leistimo/BreadboardPowerSupplyBook/BreadboardPowerSupplyTimLeishman.pdf

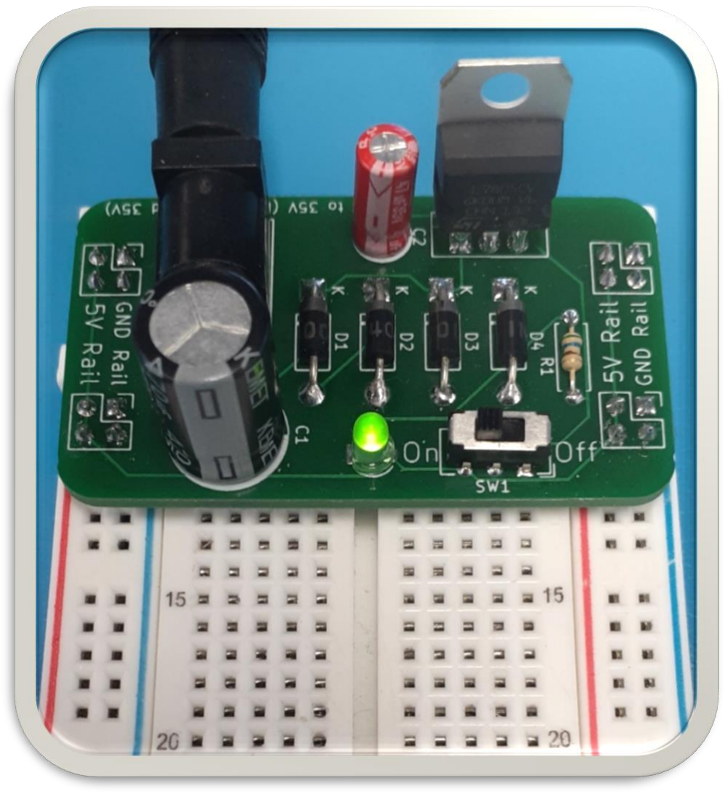
[picture p1: figure]

# Breadboard Power Supply

## Timothy Leishman

### Senior Instructor, Robotics Engineering Technology Idaho State University

## Contents

- Section 1 | Introduction | 2
- Section 2 | RMS & Peak Voltage | 4
- Section 3 | Voltage Rectification | 5
- Section 4 | Capacitive Filtering & DC Calculations | 7
- Section 5 | Voltage Regulation | 9
- Section 6 | Your First Power Supply Project | 13
- Section 7 | Zener Regulation | 16
- Section 8 | Input Polarity Correction | 20
- Section 9 | Basic Current Limiting Protection | 21
- Section 10 The Darlington Pair | 24
- Section 11 The L7805 Regulator | 26
- Section 12 Breadboard Power Supply Assembly | 29
- Conclusion | 32
- References | 33

Section 1 Introduction

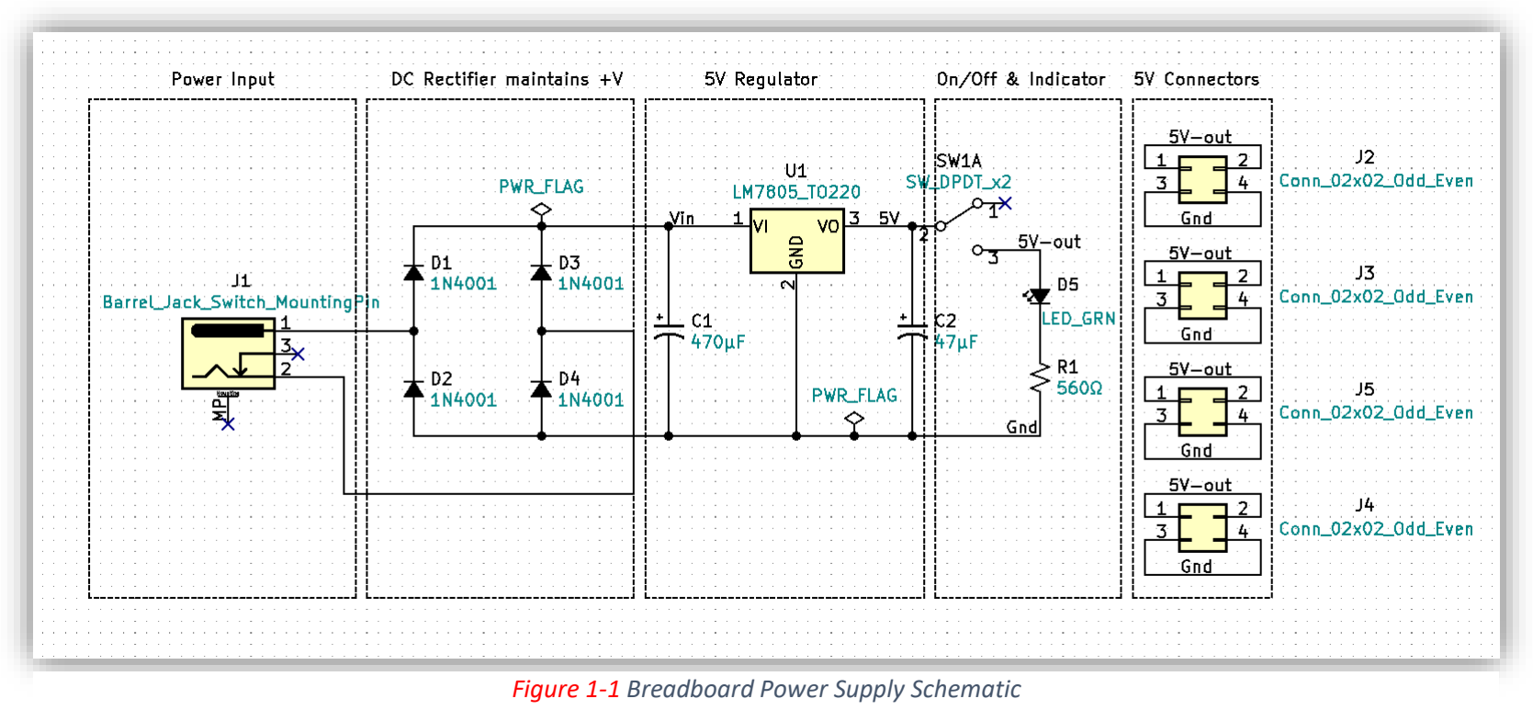
[picture p2: figure]

In addition to a global pandemic, Covid created an instant demand for online at home

learning. Suddenly electronics students everywhere lost access to laboratory bench test

equipment and the direct supervision of a lab instructor. While, I encourage advanced students to

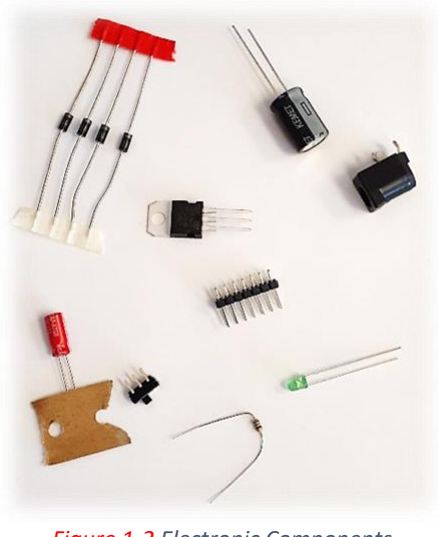
[picture p3: figure]

acquire modestly priced oscilloscopes, function generators,

and laboratory DC power supplies as they can, the

introductory student will not likely have access to these tools

at home. For these students, the Breadboard PS along with a

DMM will provide an affordable and safe, at-home circuit

prototyping solution.

The electronic circuit design process involves

defining a problem, determining a solution, completing

circuit calculations & developing a schematic, acquiring

components, testing the circuit (often referred to as breadboarding), designing a printed circuit

Figure 1-2 Electronic Components

Figure 1-1 Breadboard Power Supply Schematic board (PCB), assembling the PCB, and final PCB testing. Typically, the breadboarding stage is

done using a bench top or laboratory DC power supply. Once the breadboarding phase is

complete and the circuit is functionally operational, we often need to replace the laboratory DC

power supply with a dedicated power source. A power source can be as simple as a 9V battery or

as sophisticated as a dedicated high-power rackmount subsystem. Often, we can design our own

power supplies using basic components rather than buying the off-the-shelf unit.

While the power supply may not be the

most exciting aspect of your electronic projects it

is a crucial and foundational component. Poor

power supply design can lead to intermittent

circuit problems, premature circuit failures, and

frustration! Understanding how power supplies

operate and function will make you a better

electronic troubleshooter. The Breadboard Power

Supply will give you the ability to safely build

and test circuits. This small project will also help

you develop your soldering skills. Additionally,

learning how to safely design and build dedicated

power supplies will bring life to your current and

future electronic projects.

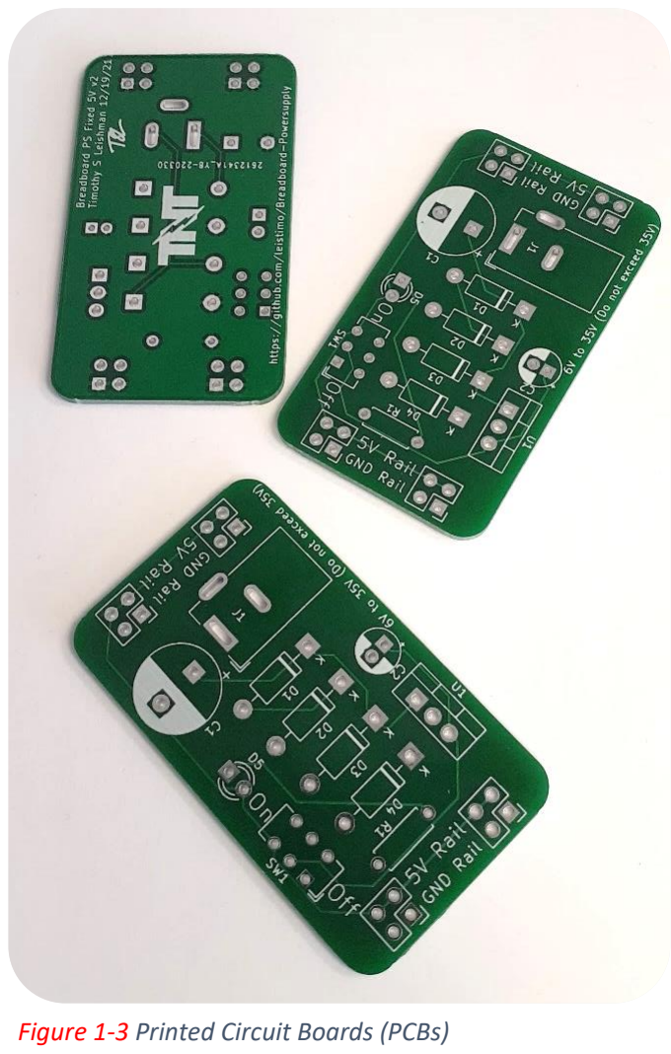
[picture p4: figure]

Figure 1-3 Printed Circuit Boards (PCBs)

Section 2 RMS & Peak Voltage

The wall outlet at your house is 120-volt rms. 120vrms is dangerous. The circuit breaker

at your house, which acts like a safety switch turning off the voltage, has the maximum current

rating of 15 amps or 20 amps. Death can occur from as low as 100mA or 0.1A. The circuit

breaker at your house is not designed to save your life from electrical shock, it is designed to

prevent the wiring in your home from overheating and starting a fire. Do not underestimate 120v

wall power it can kill you! For more safety information, see OSHA’s Basic Electrical Safety. (https://www.osha.gov/sites/default/files/2019-04/Basic_Electricity_Materials.pdf)

Wall voltage is known as AC (Alternating Current). Most of what we do in electronics is

DC (Direct Current). Examples of DC devices include: your computer, cell phone, Arduino,

Raspberry Pi, and anything powered by a battery. The motor in your RC car is DC motor.

However, some motors are designed to operate using single phase AC or industrial three phase

AC. Because our wall power is AC and our electronic circuits are predominately DC we will

need to convert the alternating wall

current to direct current, a process

called rectification.

Figure 2-1 shows a captured

image of 120vRMS wall AC. An

oscilloscope displays voltage along

the Y axis and time along the X

axis. Observe that the oscilloscope

displays the image in alternating

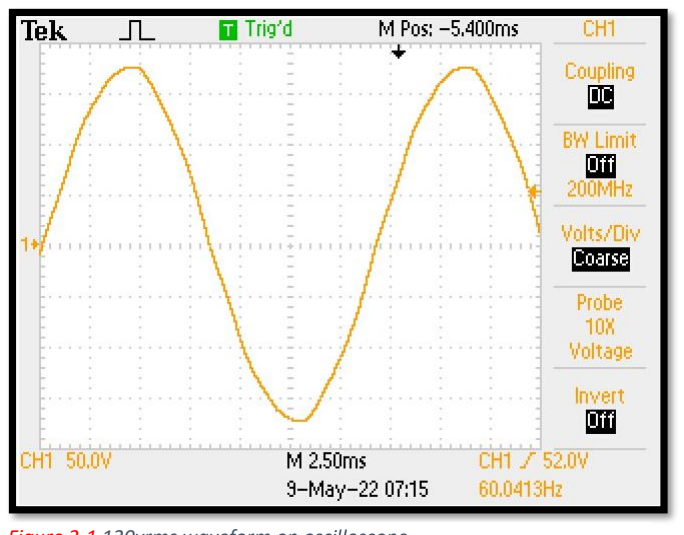
[picture p5: figure]

peak-to-peak voltage, not RMS voltage.

Figure 2-1 120vrms waveform on oscilloscope

To convert peak-to-peak voltage to RMS voltage, the following formulas can be used.

Vrms =

Vp
√2

OR Vp × 0.707. Vp is peak voltage and is equal to Vpp (peak to peak voltage)

divided by two or Vp =

Vpp
2

. In figure 2-1 note that channel 1 is set to 50 volts per division and

the waveform, peak to peak, has approximately six major divisions and two half divisions

equaling 7 major divisions. If we multiply 7div × 50v/div to get a peak to peak voltage of

350vpp. Dividing 350vpp by 2 gives us a peak voltage of 175vp. Dividing 175vp by √2

gives an RMS voltage of 123.74vRMS or 120vRMS. Peak voltage is important to understand

when we are using an oscilloscope and calculating rectification circuits. RMS is useful for

determining power. For example, the power calculations for an incandescent light bulb, audio

amplifier, and ac motor need to be calculated by multiplying the RMS voltage by the RMS

current. Using RMS voltage to calculate ac power gives us an equivalent power to DC power

calculations, meaning 1v rms × 1amp rms = 1 watt & 1VDC × 1amp DC = 1 watt. 1 watt

is the energy needed for both scenarios.

Section 3 Voltage Rectification

Voltage rectification is the process of changing AC (alternating current) to DC (direct

current). Knowing that 100mA of current can be lethal and that in-general, skin resistance of a

human is between 10KΩ & 1KΩ (1KΩ when wet), we can use Ohm’s Law, where Current =

Voltage
Resistance

, to determine a relatively safe voltage. If we convert 120vrms to peak we get vp =

120V × √2 or vp = 169.71vp. Assuming we were able to rectify the 169.71volts we can use

the human resistance of 1KΩ to determine the current potential, i amps =

169.71V
1000Ω

, i =

169.71mA. This current is potentially lethal. If 100mA is our threshold for lethal current. What

is the maximum “safe” voltage?

Calculate the max voltage by Vmax = 1KΩ × 100mA, Vmax = 100v. Where we know

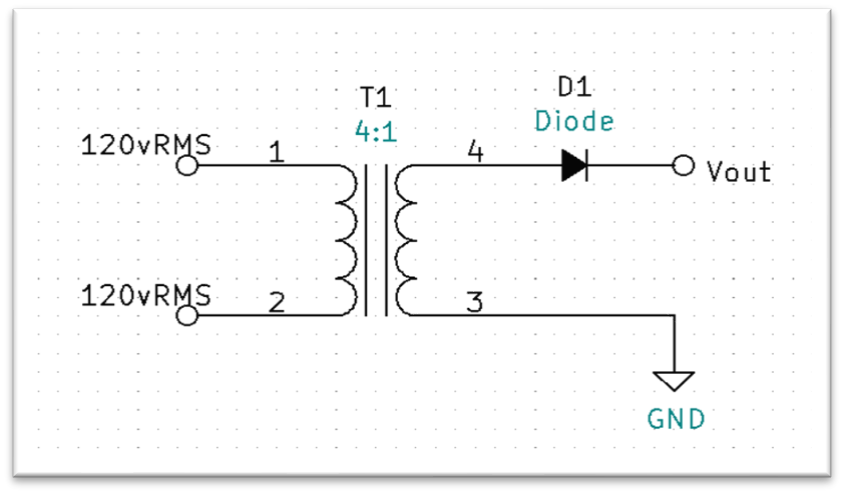
[picture p6: figure]

that 100Vs and above is potentially

lethal for humans, less than 100V

should be less than lethal. Figure 3-1

shows a basic unregulated half-wave

voltage rectifier circuit where,

transformer T1 is used for isolation

and safety. Notice that T1 has a 4:1

turns ratio. T1 is a step-down

transformer, meaning that the primary side (pins 1 & 2) have four times more turns than the

secondary side (pins 3 & 4). A step-down transformer’s secondary voltage will be divided by the

turns’ ratio. For a 4:1 transformer, vSecondary =

Vprimary
4

=

169.71vp
4

= 42.43vp. Figure 3-2

shows the secondary voltage waveform of T1

pin 3 to pin 4.

The voltage has been stepped down to

around 42vp. The waveform however, is still

AC. Observe the frequency for both fig 2-1 and

fig 3-2. Frequency is measured in hertz (Hz)

and both the primary and the secondary are

measuring the same frequency at 60Hz which

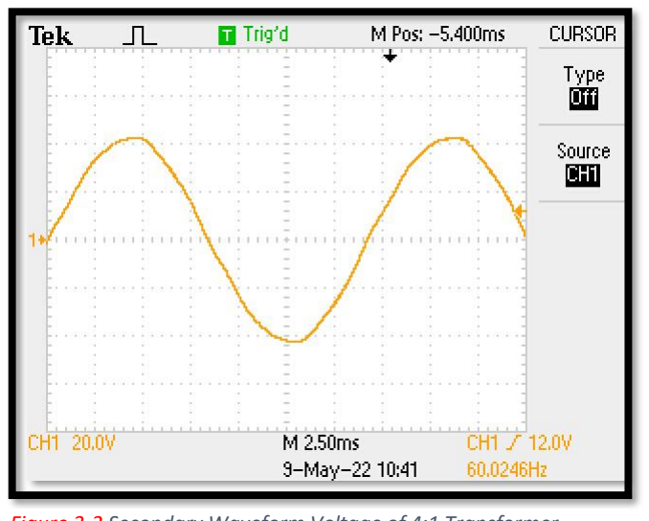
[picture p7: figure]

is the standard frequency for AC power in the United States.

Figure 3-1 Basic Half Wave Rectifier Circuit

Figure 3-2 Secondary Waveform Voltage of 4:1 Transformer

The diode D1 of Figure 3-1 will provide rectification by acting like a switch and allowing

current to flow in only one direction. When the anode is

positive with respect to the cathode, current will flow.

When the anode is negative with respect to the cathode

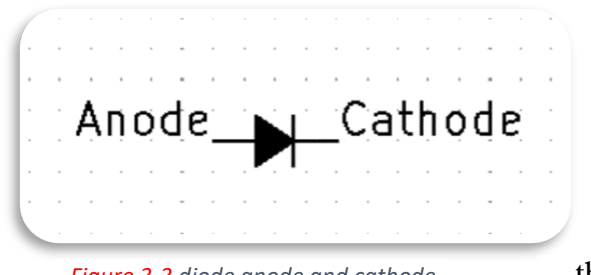
[picture p8: figure]
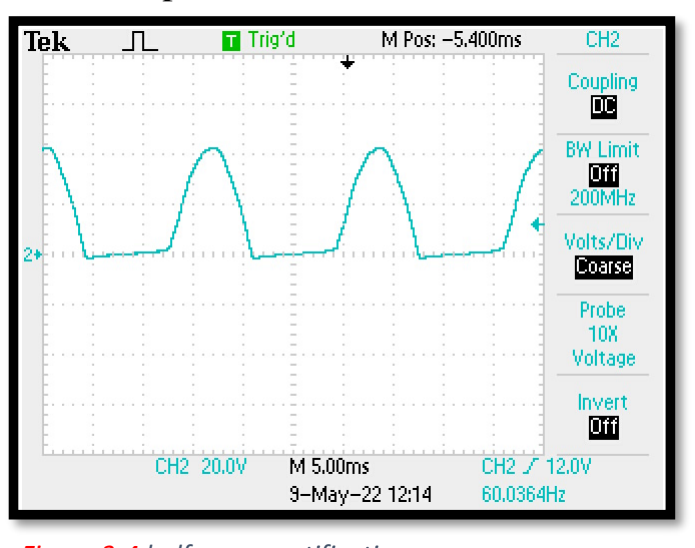
[picture p9: figure]

the diode will act like an open and no current will flow.

The output waveform will now appear to have the

negative peaks clipped off (See fig 3-4). The current

is flowing in one direction and basic half-wave

rectification has been achieved. Notice the

waveform frequency is still 60Hz for half-wave

rectification.

Section 4 Capacitive Filtering & DC Calculations

Figure 3-3 diode anode and cathode

Figure 3-4 half-wave rectification

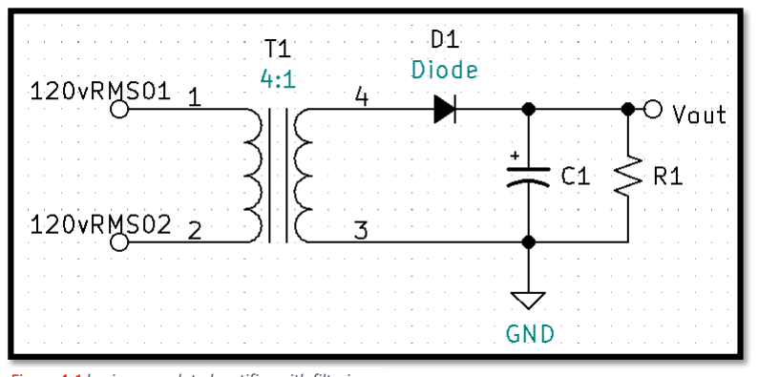
[picture p10: figure]

Figure 4-1 basic unregulated rectifier with filtering

By adding a filtering capacitor, we can smooth the ripple waveform to make it a better

DC. Figure 4-1 has added a filter capacitor C1 in parallel with load resistor R1. The capacitor

will charge immediately when the diode D1 is forward biased. When the diode becomes reverse

biased the capacitor will discharge through the load R1. With a large enough capacitance value

and load resistor the output will be a smooth DC. We can test this by using a 10uF capacitor with

no load, a 10KΩ load, and a 1KΩ load to show the varying degrees of ripple (see figures 4-2,4-3,

& 4-4).

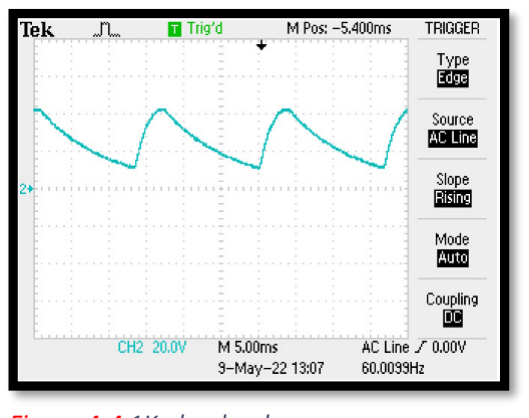
[picture p11: figure]
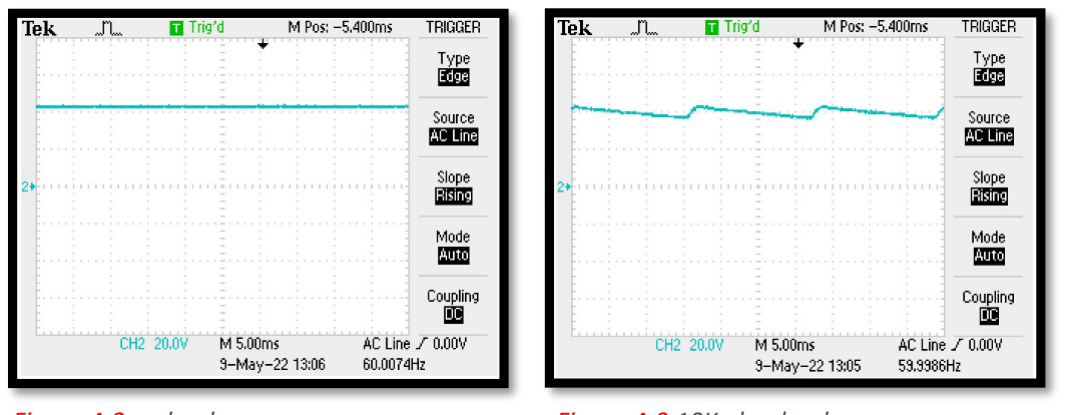
[picture p12: figure]

When there is ripple present on the waveform, VDC can be thought of as the average

waveform voltage. VDC can be calculated by adding the maximum positive peak voltage to the

minimum peak voltage and then dividing the sum by two.

Example Calculate VDC for figure 4-4:

VDC =

Vmax+Vmin
2

Vmax = 2.1 div × 20v⁄div = 42v

Vmin = 0.5 div × 20v⁄div = 10v. Now find VDC.

VDC1KΩ =

Vmax+Vmin
2

=

42v+10v
2

= 26V.

Figure 4-2 no load | Figure 4-3 10K ohm load | Figure 4-4 1K ohm load

Section 5 Voltage Regulation

For Figures 4-2, 4-3, & 4-4 observe that as the load is increased, (Ohm’s law I =

V
R

,

current or “load” increases as resistance is decreased), the ripple voltage increases and as the

ripple increases the effective DC voltage decreases.

This is an example of a rectifier circuit that is

unregulated. An unregulated power supply’s DC

voltage will decrease as the circuit load current is

increased.

For many circuits having an unregulated power

supply is a problem. Voltage regulation is required for

any circuit that requires smooth consistent DC voltage

across varying loads or current demands. Figure 5-1

shows a common collector amplifier which can be used

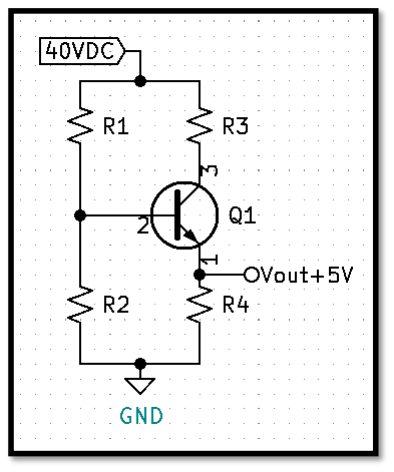
[picture p13: figure]

to provide basic voltage regulation. To calculate the needed resistors R1 thru R4, an output

voltage must be determined. Next, determine the maximum current need for your circuit. For this

example, we will use 5V with a maximum current need of 5mA. Calculate the base current (pin

2) of the transistor by dividing the 5mA emitter current (pin 1) by the minimum beta (also known

as hfe) per the data sheet. The minimum hfe for the 2N3904 with a collector current near 5mA

will be will be between 80 and 100, see figure 5-2.

- IB ≈

5mA
90

≈ 55.556μA

Figure 5-2 data sheet excerpt for a 2n3904 transistor

Figure 5-1 Basic Voltage Regulation Circuit

With IB known, make IR2 a minimum of 10 times larger.

- IR2 ≥ (10 × IB) ≥ (10 × 55.556μA) ≥ 555.556μA

Use Kirchhoff’s Voltage Law to calculate VR2.

- VR2 = VR4 + VBE = 5V + 0.7V = 5.7V

Use Ohm’s Law to calculate R2

- R2 =

VR2

IR2

=

5.7V
min555.556μA

= 10.26KΩ

- Round down to next standard value, R2 = 10KΩ

Recalculate IR2 using standard value.

- IR2 =

VR2
R2

=

5.7V
10KΩ

= 570μA

Calculate IR1 using Kirchhoff’s Current Law.

- IR1 = IB + IR2 = 55.556μA + 570μA = 625.556μA

Calculate VR1 using Kirchhoff’s Current Law.

- VR1 = VCC − VR2 = 40V − 5.7V = 34.3V

Calculate R1 using Ohm’s Law.

- R1 =

VR1

IR1

=

34.3V
625.556μA

= 54.831KΩ

R3 is used to help split the power from the transistor. Power for the transistor is calculated using

the max current IC multiplied by VCE.

- PQ1 = ICmax × VCE
- ICmax ≈ 5mA
- VCEmax = VCC − VR4 = 40V − 5V = 35V
- Now make VCE =

VCEmax
2

=

35
2

= 17.5V

- PQ1 = ICmax × VCE = 5mA × 17.5V = 87.5mW

Calculate VR3 using Kirchhoff’s Voltage Law.

- VR3 = VCC − VCE − VR4 = 40V − 17.5V − 5V = 17.5V

Calculate IR3.

- IR3 ≈ 5mA

Calculate R3 using Ohm’s Law.

- R3 =

VR3

IR3

=

17.5V
5mA

= 3.5KΩ

Figure 5-3 displays the regulation circuit with

standard values. Figure 5-4 shows the entire

rectification circuit with voltage regulation

added. Notice the second 10uF capacitor C2 at

the base of the transistor. This is used to keep the

voltage and current at the base of the transistor

extra stable. Figure 5-4 transistor orientation is

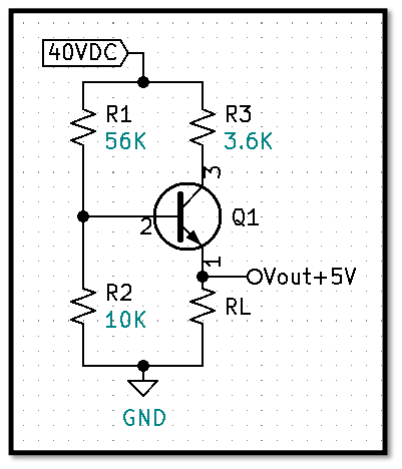
[picture p14: figure]

also drawn in the more typical manner for a power supply.

Figure 5-3 Basic Regulation Circuit with Standard Values.

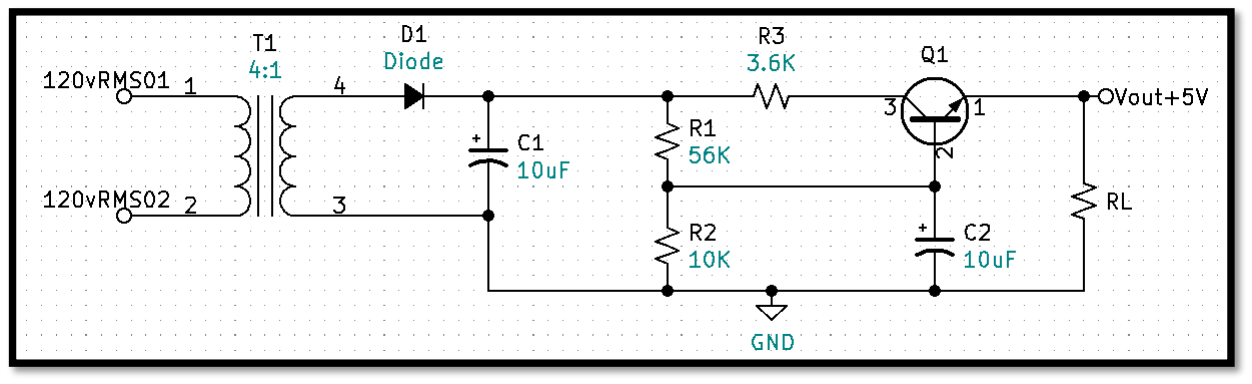
[picture p15: figure]

Figure 5-4 Basic Rectification Circuit with Voltage Regulation

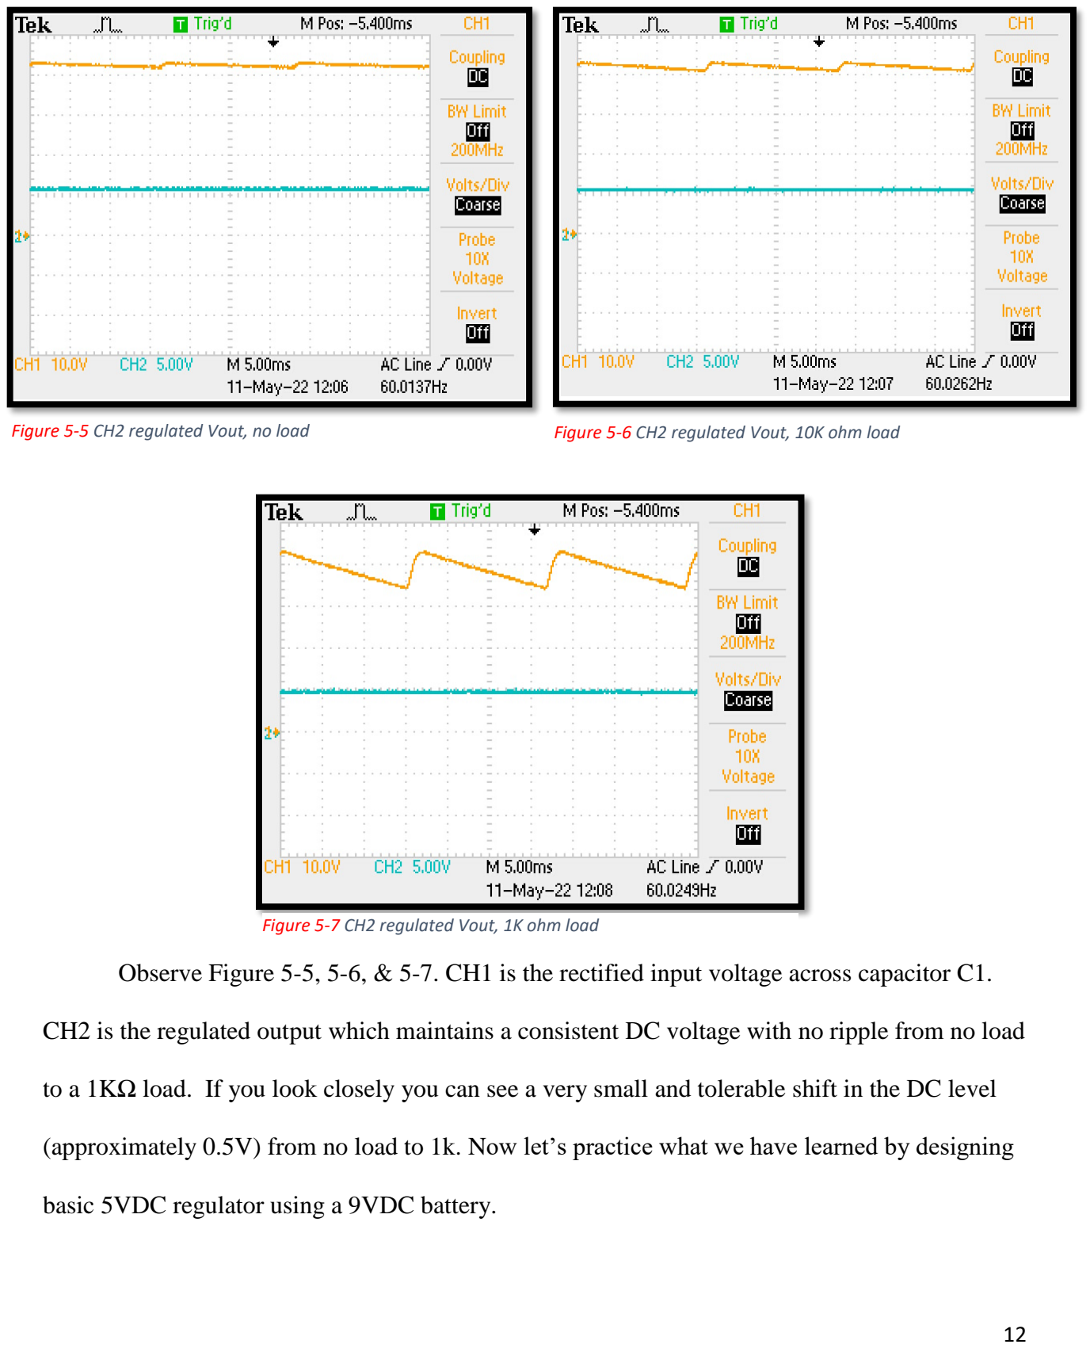
[picture p16: page 13]

Observe Figure 5-5, 5-6, & 5-7. CH1 is the rectified input voltage across capacitor C1.

CH2 is the regulated output which maintains a consistent DC voltage with no ripple from no load

to a 1KΩ load. If you look closely you can see a very small and tolerable shift in the DC level

(approximately 0.5V) from no load to 1k. Now let’s practice what we have learned by designing

basic 5VDC regulator using a 9VDC battery.

Figure 5-5 CH2 regulated Vout, no load | Figure 5-6 CH2 regulated Vout, 10K ohm load

Figure 5-7 CH2 regulated Vout, 1K ohm load

Section 6 Your First Power Supply Project

We learned previously that the human skin resistance is around 1KΩ when wet and

10KΩ when dry. We also learned that 100mAs of current is potentially lethal. If we use a 9VDC

battery as our voltage source, what is the maximum current through wet skin and minimum

current through dry skin potential exposure? (use Ohm’s Law)

- Wet skin: Iwet =

V
R

=

9V
1KΩ

= 9mA

- Dry skin: Idry =

V
R

=

9V
10KΩ

= 900μA

With dry skin you will not be able to feel or perceive the less than 1mA of current from a

9V battery. If wet however, you could potentially feel a non-lethal shock. Regardless of the

voltage level you are working with, remove all metal jewelry. Metal jewelry can cause severe

burns even when working with low voltage.

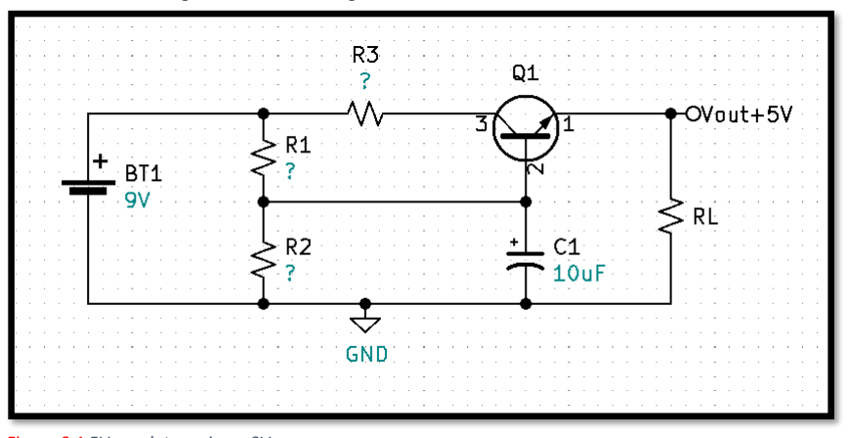
[picture p17: figure]

First Challenge: Calculate and find the resistor values for the circuit in Figure 6-1 to produce a

regulated 5V output with a max current of 5mA. Assume Q1 is a 2N3904 with a minimum beta

of 90.

Figure 6-1 5V regulator using a 9V source

Solution for First Challenge:

Find the maximum base current IB for Q1.

- IBmax ≈

IEmax
Betamin

≈

5mA
90

≈ 55.556μA

Make IR2 ≥ 10 x IBmax.

- IR2 ≥ 10 × 55.556μA ≥ 555.556μA

Find VR2 using Kirchhoff’s Voltage Law.

- VR2 = VBE + VRL = 0.7V + 5V = 5.7V

Find approximate R2 value using Ohm’s Law.

- R2 ≤

VR2

IR2

≤

5.7V
555.556μA

≤ 10.26KΩ

Round R2 value down to a standard value.

- R2 = 10KΩ

Recalculate IR2 using Ohm’s Law.

- IR2 =

VR2
R2

=

5.7V
10KΩ

= 570μA

Find IR1 using Kirchhoff’s Current Law.

- IR1 = IR2 + IB = 570μA + 55.556μA = 625.556μA

Find VR1 using Kirchhoff’s Voltage Law.

- VR1 = VBT1 − VR2 = 9V − 5.7V = 3.3V

Calculate R1 using Ohm’s Law.

- R1 =

VR1

IR1

=

3.3V
625.556μA

= 5.28KΩ

Determine R3. First ask yourself what the total power of Q1 is without R3 and if that

power needs to be split.

- PQ1 = ICmax × VCE
- VCEmax = VBT1 − VRL = 9V − 5V = 4V
- ICmax = 5mA
- PQ1 = ICmax × VCE = 5mA × 4V = 20mW

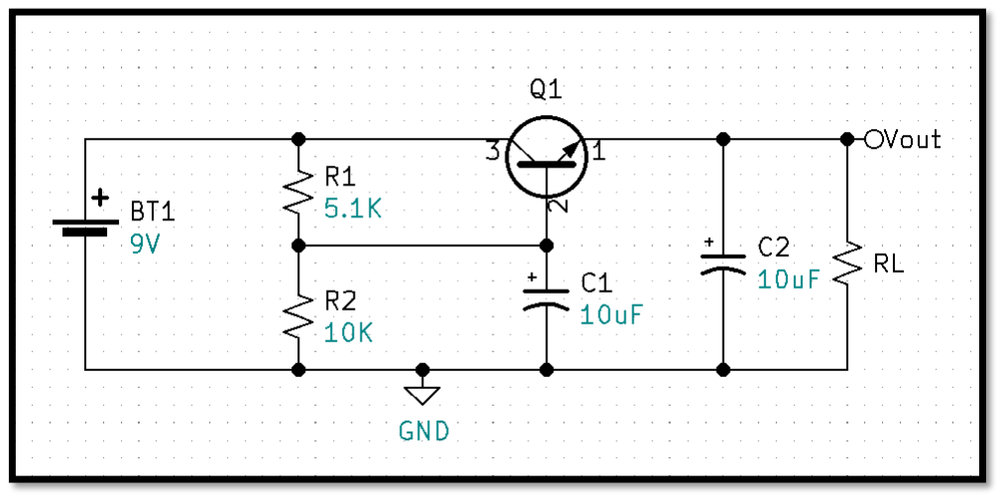
[picture p18: figure]

The absolute maximum power rating for a 2N3904 is 625mW. Optimal power operation

for the 2N3904 will be less than or equal to half the absolute maximum rating, approximately

300mW. Because we are well below the optimal power operation at 20mW, R3 is not required

for this circuit.

With figure 6-2 assembled and tested, the output measured a smooth 5.04V with a 1KΩ

load resistor and 5.44V with no load. This circuit works well for a specific input voltage, in this

case 9VDC. Let’s say we want to design a circuit that has the ability to accept a variety of input

voltages instead of just 9V. How might we deal with a range of input voltages and still maintain

a regulated output of 5V?

Figure 6-2 Test Circuit - R1 Standard Value, Additional Filter Cap C2.

Section 7 Zener Regulation

If you are like me, you have a box full of salvaged

electronic components. I have one dedicated to wall

ACDC power adapters as seen in Fig. 7-1. These wall

adapters, sometimes referred to as “wall warts” take care

of voltage rectification for us by internally converting the

120Vrms AC voltage to a fixed DC voltage. Typically,

the output voltage and current specifications are written

on the adapter. The adapter in Fig 7-1 is listed as having

an output of 10.5V that can supply up to 900mAs of

current. Let’s say I also have a wall adapter that has a

12V output and third that has a 20V output. Can we

design a single circuit that will accommodate each of

those inputs and still provide a regulated 5V output? By

replacing R2 in our previous circuit with a Zener diode

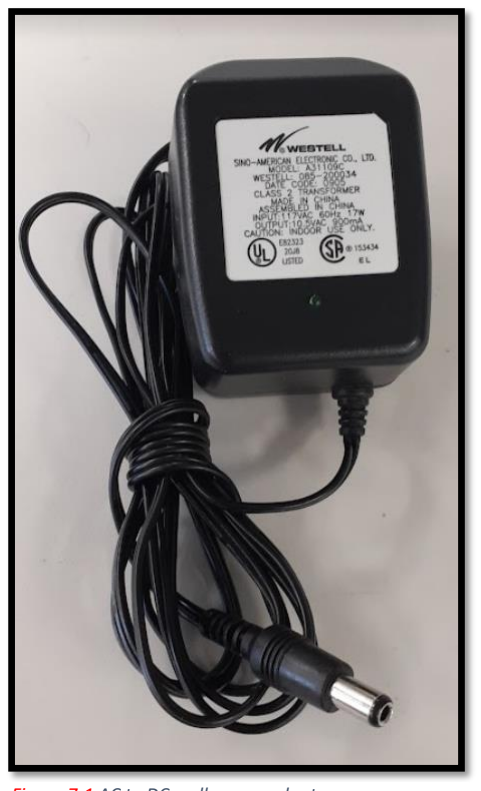
[picture p19: figure]

we can achieve regulation throughout a range of input voltages.

Figure 7-1 AC to DC wall power adapter with barrel jack connector

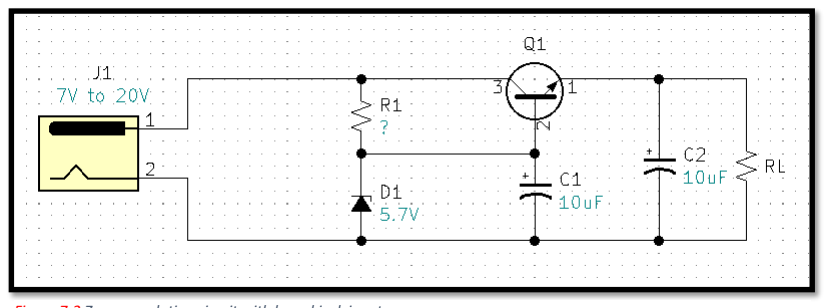
[picture p20: figure]

Figure 7-2 Zener regulation circuit with barrel jack input

R1 Calculations for Fig 7-2:

Ideally D1 would be a 5.7V Zener,

I had on hand a 1N5233 6V Zener diode.

Concerning Zener diodes, there are two

important specifications we need to know,

the maximum Zener current (IZM) and the

minimum Zener current known as knee

current (IZK). According to the data sheet

the maximum power for my Zener is

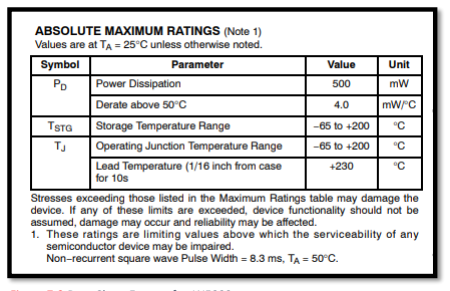
[picture p21: figure]

500mW. With this information we can calculate IZM.

Calculate IZM using the power formula.

- P = I × V
- I =

P
V
- IZM =

PZMax
VZ

=

500mW
6V

= 83.333mA

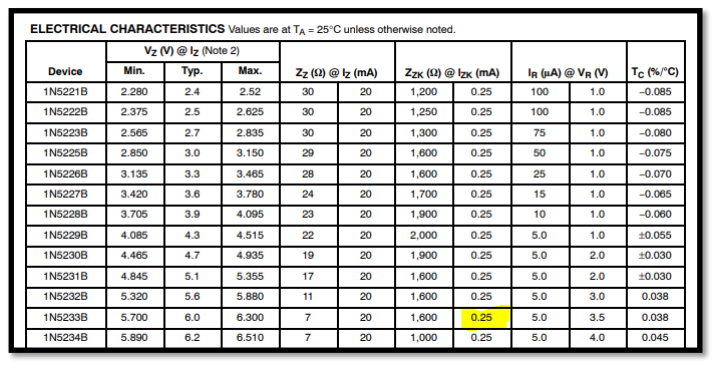
[picture p22: figure]

See Fig 7-4, according to the data sheet IZK = 0.25mA for the 1N5233 Zener diode.

Figure 7-3 Data Sheet Excerpt for 1N5233

Figure 7-4 Data Sheet IZK

You can determine your minimum input voltage by adding a minimum of two volts to

your regulated output voltage. This extra voltage is needed for the linear regulator to have at

least two volts VCE across the transistor. The transistor will lose regulation if its VCE drops too

low. For our example with a 5V output we would need a minimum of 7VDC for an input. Now

imagine that the input is 7V and the 6V Zener is doing its job. Using Kirchhoff’s Voltage Law,

we can see that VR1 will equal 1V. Here is the math.

With the input Voltage set to 7V:

- VR1 = Vin − VZ = 7V − 6V = 1V

We know that the Zener requires a minimum current of IZK therefore:

- R1 =

VR1

IZK

=

1V
0.25mA

= 4KΩ, round down to next standard value of 3.9KΩ

With the maximum input voltage of 20V chosen, verify IZ does not exceed IZM = 83.333mA.

With the input Voltage set to 20V:

- VR1 = Vin − VZ = 20V − 6V = 14V
- IZ =

VR1
R1

=

14V
3.9KΩ

= 3.59mA

- IZ is less that IZM, and within specifications.

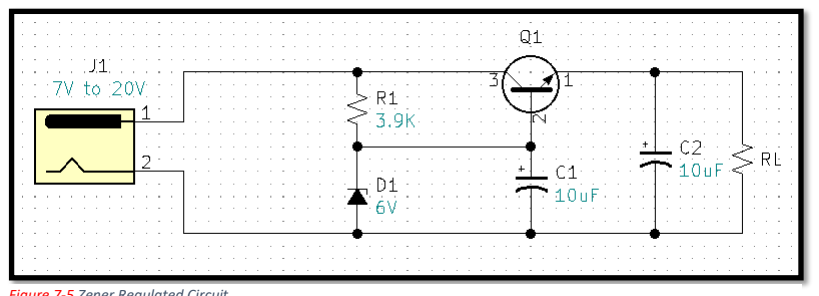
[picture p23: figure]

Figure 7-5 Zener Regulated Circuit

One more calculation that should be verified is the power of Q1when the input is at max 20V.

- PQ1 = IRLmax × VCE
- IRLmax = 5mA
- VCEmax = VINmax − VRL = 20V − 5V = 15V
- PQ1 = IRLmax × VCE = 5mA × 15V = 75mW
- PQ1 = 75mW is less tℎe maximum power for a 2N3904, PMax2N3904 = 625mW

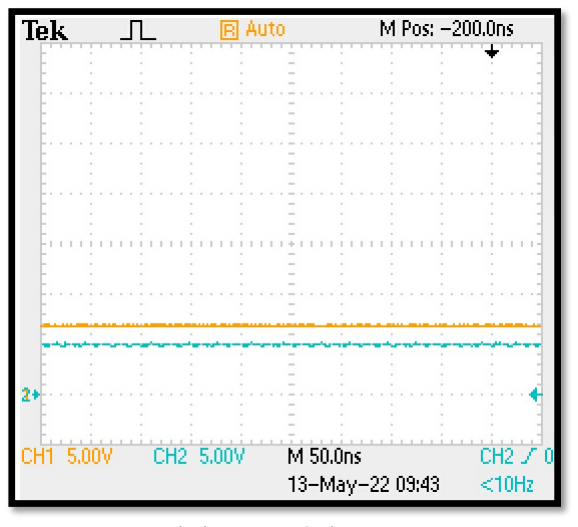
[picture p24: figure]

With Zener regulation we

can now regulate a range of

input voltages. Beware only

some barrel jack connectors that

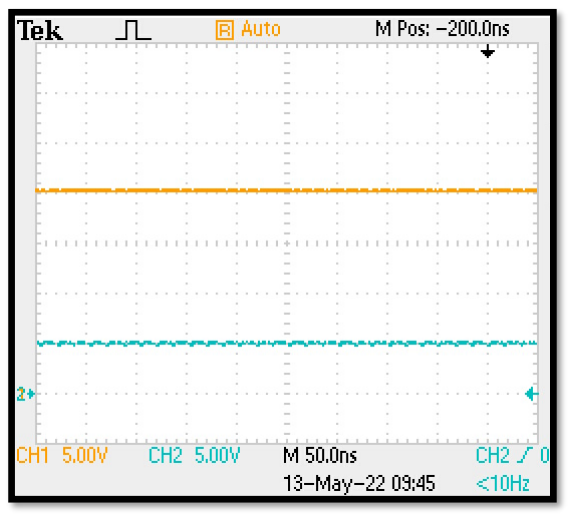
[picture p25: figure]
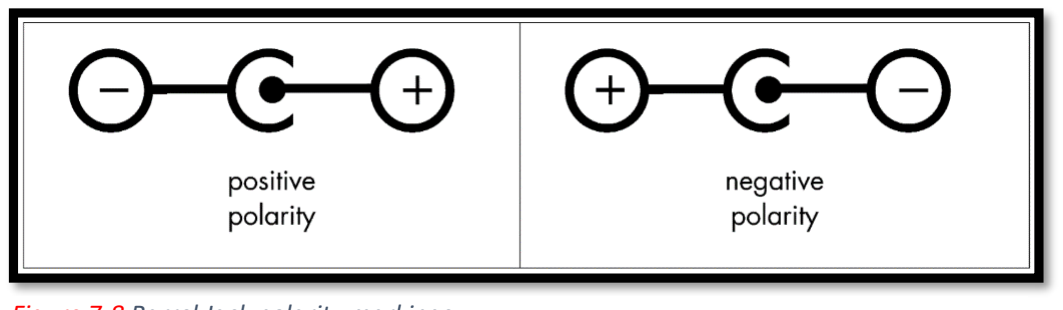
[picture p26: figure]

have a positive center pin. Have you ever noticed the symbol markings on your AC wall adapters

similar to Fig 7-8? In my box of salvaged adapters, I have some unmarked, some center positive,

and some center negative. Currently, we could damage our circuit, or the wall adapter, if we used

Figure 7-6 Measured, Ch1 7V input & Ch2 5V output. | Figure 7-7 Measured, Ch1 20V input & Ch2 5V output.

Figure 7-8 Barrel Jack polarity markings unmarked or center negative adapters. How could our circuit be fixed so that it could accept both

positive and negative center pin polarities and still output a fixed +5V?

Section 8 Input Polarity Correction

Similar to how we used diodes in our AC to DC voltage rectification circuit, we can use

diodes to provide DC polarity correction. For this example, I am using 1N4001 general purpose

diodes for D1-D4.

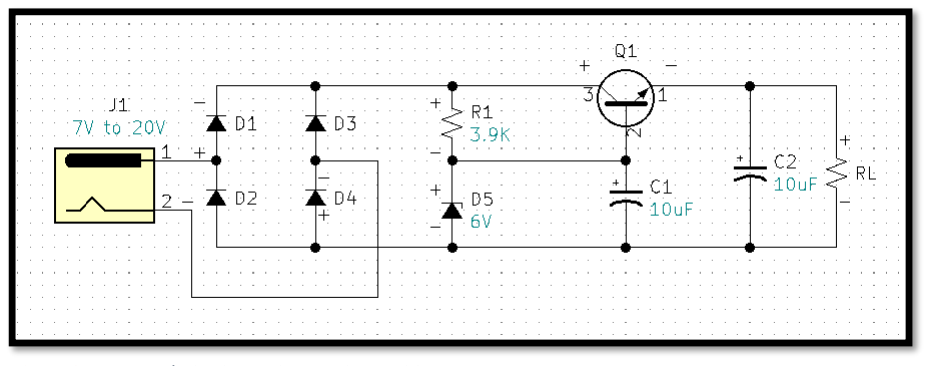
[picture p27: figure]
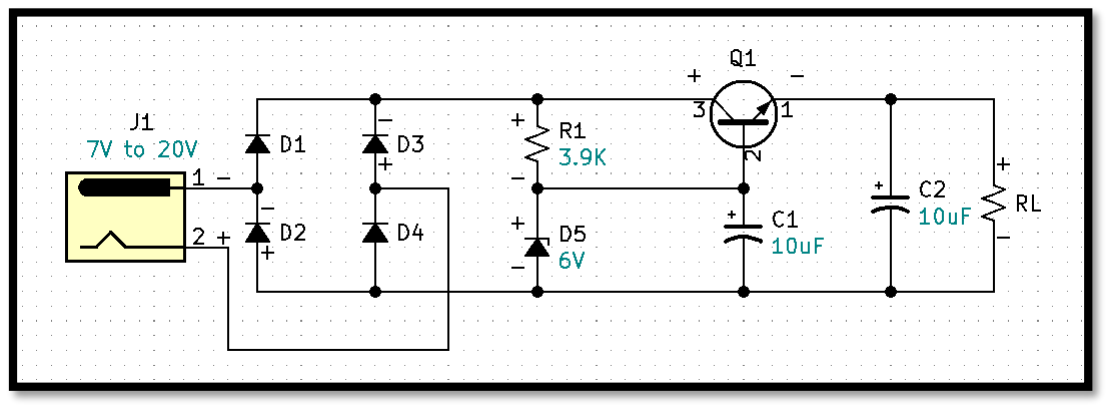
[picture p28: figure]

Observe Figure 8-1 where J1 pin 1 is positive with respect to pin 2, diodes D1 and D4 are

forward biased and diodes D2 and D3 are reverse biased. The result is the rest of the circuit is

properly biased. Observe Figure 8-2 where J1 pin 1 is negative with respect to pin 2, diodes D2

and D3 are forward biased and diodes D1 and D4 are reverse biased. The result is the rest of the

Figure 8-1 Input Polarity Correction, J1 Pin1 Positive.

Figure 8-2 Input Polarity Correction, J1 Pin1 Negative.

circuit is again properly biased. Therefore, the circuit is now adapted to receive either positive,

negative, or unknown voltage polarities. This circuit makes virtually all of our salvaged wall

adapters useable. I assembled and tested the circuit with +20VDC input measured +5.08VDC at

the output with a 1KΩ load. I also tested with -20VDC input and also measured +5.08VDC at

the output with a 1KΩ load.

What happens to this circuit if the output is shorted? The answer is the transistor will

exceed its power specifications and destroy itself. None of the previous circuits have had current

limiting protection. If you are building a dedicated circuit that will be deployed with a fixed load

and a fixed input voltage, and you can guarantee that the output will never be shorted, the

previous circuits may work fine. However, current limiting circuit protection is always a good

idea. What is a simple way to apply current limiting protection to our circuit?

Section 9 Basic Current Limiting Protection

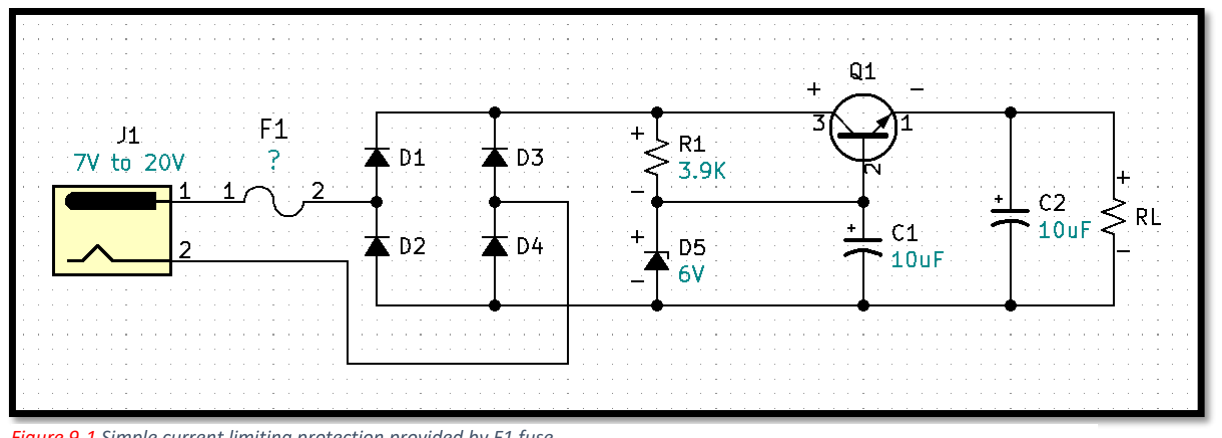
[picture p29: figure]

A fuse can provide basic current limiting protection for your circuit. To determine the

proper fuse value, we need to consider all the parts that will be affected when the output is

shorted or overloaded. We can see that Q1 and the polarity correction diodes are in the direct

Figure 9-1 Simple current limiting protection provided by F1 fuse.

path between the voltage source and the output. Additionally, we should consider the output

rating on the AC/DC wall adapter. All wall adapters will be rated differently. As previously

mentioned, my adapter is rated at 900mA. According to the data sheet the 1N4001 diodes are

rated at a maximum forward current of 1A. And the 2N3904 BJT is rated at an absolute

maximum forward DC current of 200mA. So, for this circuit we will need to protect the weakest

link which is the 2N3904 BJT at 200mA. If your wall adapter is rated less than 200mA, your

fuse choice would be based on that current. Because 200mA is the absolute maximum, we will

want to guarantee that the current stays well below 200mA. Our circuit is designed to run at 5mA

so our fuse will need to be larger than 5mA and well below 200mA. An appropriate fuse for this

circuit is a slow blow 100mA or 0.1A fuse.

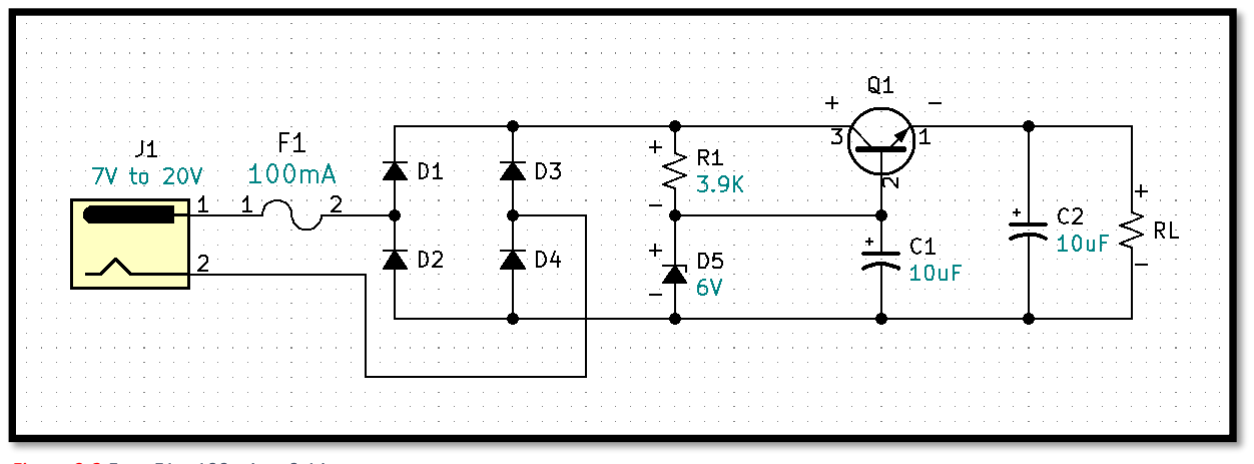
[picture p30: figure]

We know the transistor Q1 can handle a forward current of 100mA. We need to

recalculate the transistors power with a load current of 100mA and determine if the power at Q1

is still in specification.

New Calculations:

- RL@100mA =

VRL

IRL

=

5V
100mA

= 50Ω

Figure 9-2 Fuse F1 = 100mA or 0.1A

- PQ1@100mA = VCEmax × ICmax
- VCEmax = VINmax − VRL = 20V − 5V = 15V
- ICmax = F1 = 100mA
- PQ1@100mA = VCEmax × ICmax = 15V × 100mA = 1.5 watts

PQ1 at 1.5 watts is too high for the 2N3904. There are two ways we can deal with this

problem. The first is to do a power split by adding a series parasitic power resistor in the path of

the collector of the transistor just like we did previously with R3 in the rectifying circuit Fig. 5-1.

The second option is to use a Darlington Pair.

First let’s calculate the parasitic power resistor.

- Ptotal = 1.5 watts
- PQ1max = 625mW
- PR2max = Ptotal − PQ1max = 1.5 watts − 625mW = 875mW
- VR2 =

PR2max

ICmax

=

875mW
100mA

= 8.75V

- R2 =

VR2

ICmac

=

8.75V
100mA

= 87.5Ω

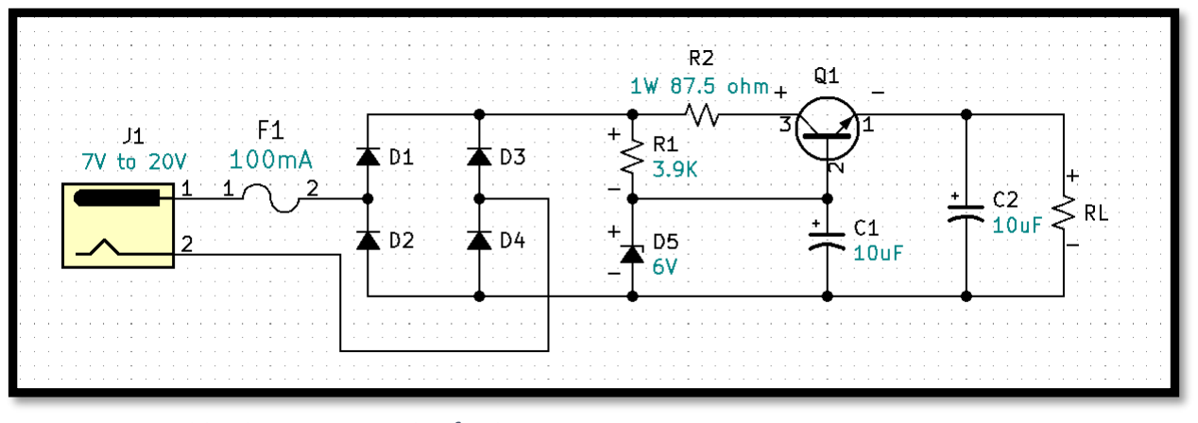
[picture p31: figure]

The circuit Fig 9-3 will work fine when the load is 5mA. However, now that we can

operate up to 100mA without damaging any of the parts, a problem has been introduced via R2.

Can you spot the problem?

Figure 9-3 Parasitic R2 power protection for Q1

If we want to operate our output at 99mA, what is the required input voltage for Fig 9-3?

Calculate the required input voltage when the output is running a 99mA load.

- Vin = VD1 + VD4 + VR2 + VCE + VRL
- VD1&D4 = 0.7V
- VR2 = IC × R2 = 99mA × 87.5 = 8.663V
- VCEmin = 2V
- VRL = 5V
- Vin = 0.7 + 0.7 + 8.663 + 2V + 5V = 17.063V
- Vin = 17.063V

A Vin requirement of 17V for our circuit is not practical. Using this method would

severely limit the flexibility of this circuit. A preferable method is to use a Darlington Pair with

a higher-powered transistor.

Section 10 The Darlington Pair

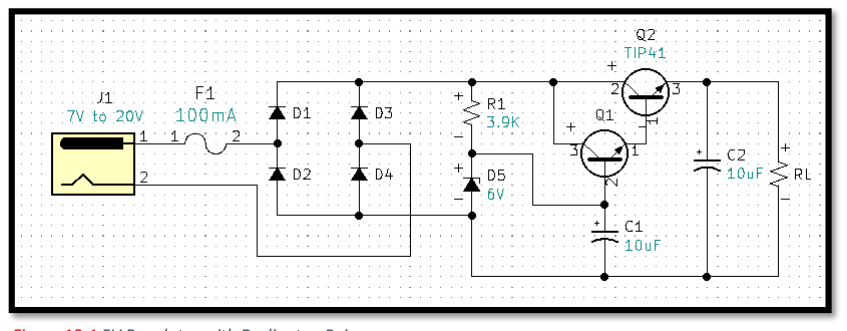
[picture p32: figure]

The Darlington Pair Q1 & Q2 is a current multiplier. The power transistor TIP 41 is able

to handle more power than the 2N3904. A question you may be thinking: why not omit the

2N3904 Q1 transistor and replace it with the power transistor TIP41? The answer is, power

transistors have a much lower beta or hfe than general purpose transistors. Therefore, our base

Figure 10-1 5V Regulator with Darlington Pair.

current would go up significantly and we would still need 10X current through the Zener. We

would also need to keep our IZ current below IZM. Additionally, the increase in IZ would

require a recalculation of the R1 value to accommodate the increase in current. This would

negatively impact our efficiency, we don’t want more quiescent current to go directly to ground

through the Zener. Imagine if your power supply was battery powered, an increase in IZ would

discharge your battery faster. By adding the Darlington, we can keep the current through the

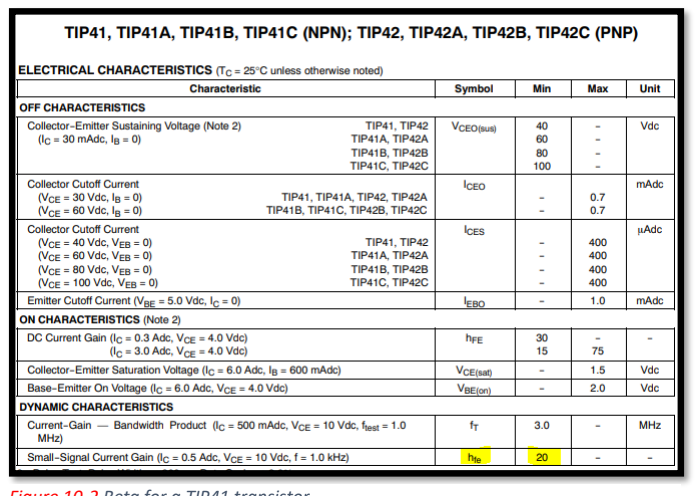
[picture p33: figure]

Zener significantly lower, while

increasing the current through the

load. With the Darlington Pair, if

the circuit was run at its maximum

current of 100mA, what would the

current at the base of Q1 be?

- RL =

V
I

=

5V
100mA

= 50Ω:

- IRL =

VRL
RL

=

5V
50Ω

= 100mA

- IEQ2 = IRL = 100mA
- IBQ2 ≈

IEQ2
TIP41Betamin

≈

100mA
?

(see fig 36 for beta/hfe min)

- IBQ2 ≈

100mA
20

≈ 5mA

- IEQ1 ≈ IBQ2 ≈ 5mA
- IBQ1 ≈

IEQ1
2N3904Betamin

≈

5mA
90
- IBQ1 ≈

IEQ1
2N3904Betamin

≈ 55.556μA

Figure 10-2 Beta for a TIP41 transistor.

Note, our output prior to the Darlington Pair was designed for a maximum 5mA, we

decided to increased output load capability to 100mA. This is a current gain or increase of 20.

Adding the Darlington pair with a TIP41 power transistor solved two problems. The first was the

TIP can handle the increased circuit power and the second the TIP41 with its minimum beta of

20 gave the Darlington a current magnification factor of 20, keeping the base current of Q1 and

IZ the same which allows R1 to remain the same.

I assembled and tested the regulator circuit fig 10-1. The circuit was tested with 20V &

7V inputs and with 1KΩ & 50Ω loads. The circuit performed as expected with a regulated output

of 5V for each scenario. This circuit works great however, we should consider the limitations

and associated cost. For Q2 any power over two watts will require that the TIP41 have a heat

sink. A heat sink is a relatively expensive component. The TIP41 cost itself is just under a dollar.

The Zener diode, the fuse and a fuse holder also add cost. Is there a single component that could

replace the fuse, fuse holder, Zener diode, and both bipolar junction transistors?

We can purchase an off the shelf, dedicated, all in one 5V (and other standard value)

linear voltage regulators for less than a dollar!

Section 11 The L7805 Regulator

The L7805 is a 5V fixed linear regulator with internal current limiting and built-in

temperature protection. The L7805 is part of the L78 series of linear regulators. The L78 series

can be purchased as 5V, 6V, 8V, 8.5V, 9V, 12V, 15V, 18V, and 24V regulators. One point to

understand is linear regulators can only regulate down, they cannot regulate up. For the L7805

5V regulator the input voltage can be minimum of 6V to an absolute maximum voltage of 35V.

At the time of writing this document I can purchase a single L7805 for $0.62.

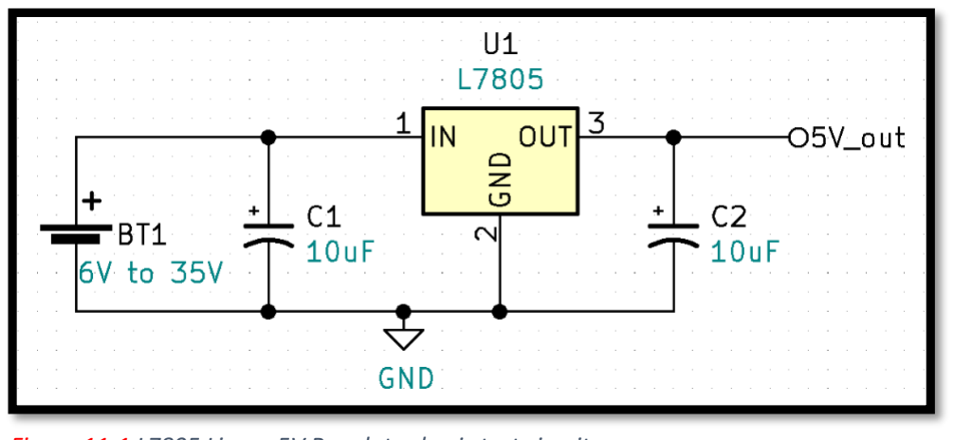
[picture p34: figure]
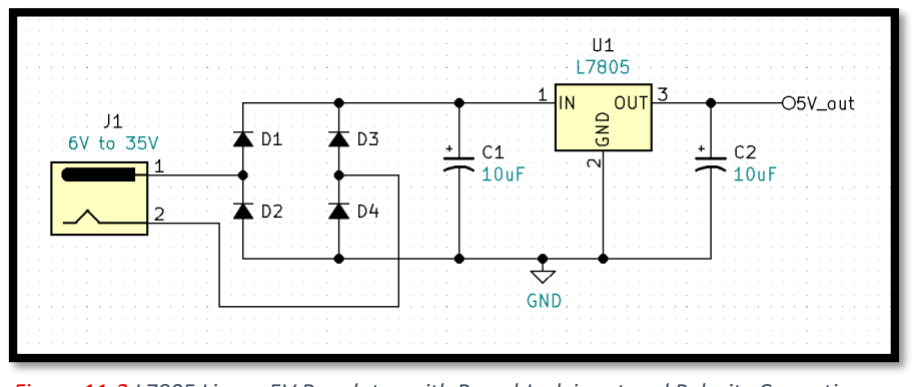
[picture p35: figure]

Notice that in Fig 11-1 circuit the fuse has been removed. This is because the L7805 has

internal current limiting and over temperature protection which will provide adaquate protection

for the circuit. Fig 11-2, Diodes D1 – D4 provide polarity correction, ensuring that pin1 of the

L7805 is always positive.

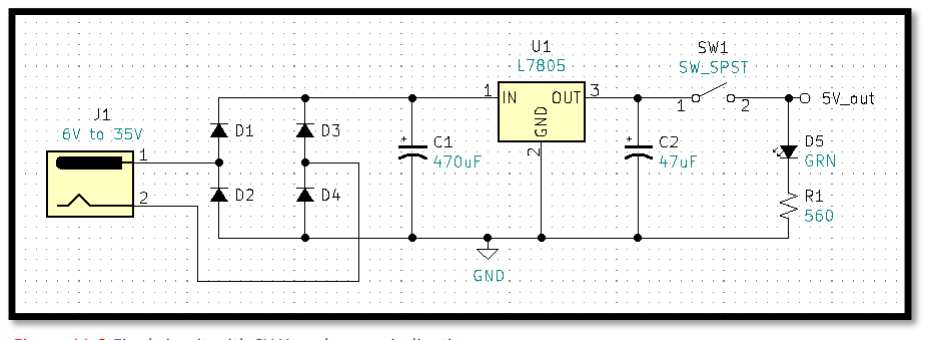
[picture p36: figure]

Figure 11-3 is the final circuit. The capacitor values are increased for additional filtering.

SW1 was added for switchable output voltage. The logical position for this SW1 would have

Figure 11-1 L7805 Linear 5V Regulator basic test circuit

Figure 11-2 L7805 Linear 5V Regulator with Barrel Jack input and Polarity Correction

Figure 11-3 Final circuit with SW1 and power indication been at the input. However, this project has a small size or form factor and the micro switch is

used is rated at 6V, so the problem with putting the switch in series with J1 is that it would be out

of specification due to overvoltage. The problem with SW1 current position is the quiescent

current of the L7805. Linear regulators are inefficient when compared to switch mode power

supplies. The inefficiency of the L7805 is due to the fact that the regulator requires a certain

amount of current to operate even if there is no load at the output. This would be comparable to

the Zener current in the previous circuits. This current is called quiescent current and the

typical quiescent current, per the data sheet, for a L7805 is 3.2mA. If you are using a 9V battery

and a barrel adapter to power your breadboard power supply circuit you will need to unplug the

barrel jack after testing to ensure the battery does not drain down. The typical 9V battery is rated

at 500mAh, meaning if you run the battery at 500mAs, it will be drained in one hour. So, if our

linear regulator requires 3.2mAs and we have no load (no current) at the output, how long will it

take to drain the 9V battery?

- 500mA = 1ℎour, 3.2mA = x ℎours?
- x =

5oomA×1ℎour
3.2mA

= 156.25 ℎours

If you leave your 9V battery plugged into the breadboard power supply with no load at

the output, you will have a dead battery after 156 hours. I considered not having a switch at all,

making the circuit even simpler, and forcing the operator plug and unplug the barrel jack.

However, I like having the ability to switch on and off the 5V GND rails on the breadboard and

the goal of this project was to be able to use salvaged barrel jack ACDC wall adapters.

The green LED D5 provides on/off output indication. The maximum current rating for

the LED is 30mA. The forward voltage for this green LED is approximately 2V. This leaves us

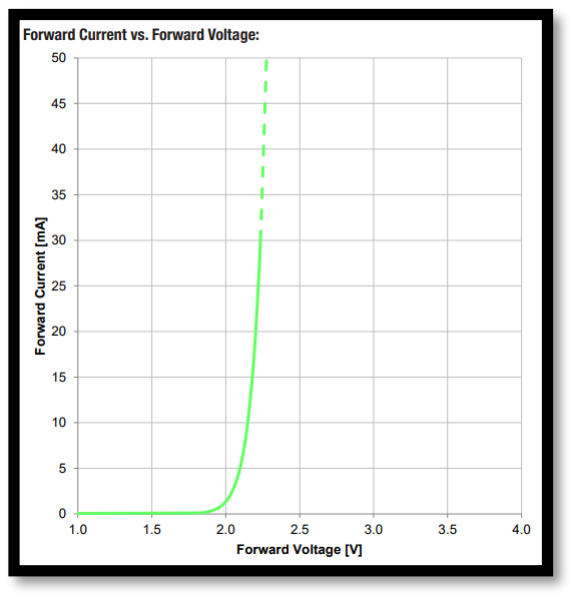
[picture p37: figure]

with 3V across the current limiting resistor R1. What is the

minimum resistance that R1 can be without exceeding the

diodes 30mA max current?

R1min =

3V
30mA

= 100Ω

As R1’s resistance value is

increased, the LEDs forward

current will decrease, and the

LEDs luminous intensity will decrease. Bench testing found that a

560Ω resistor provides a minimum current with adequate LED

illumination.

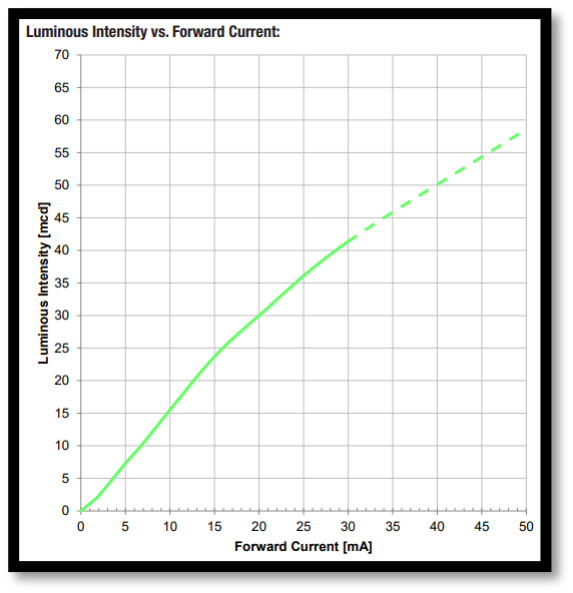
[picture p38: figure]

Section 12 Breadboard Power Supply Assembly

Figure 11-5 LED Intensity vs. Forward Current

Figure 11-4 LED Forward Current vs. Forward Voltage

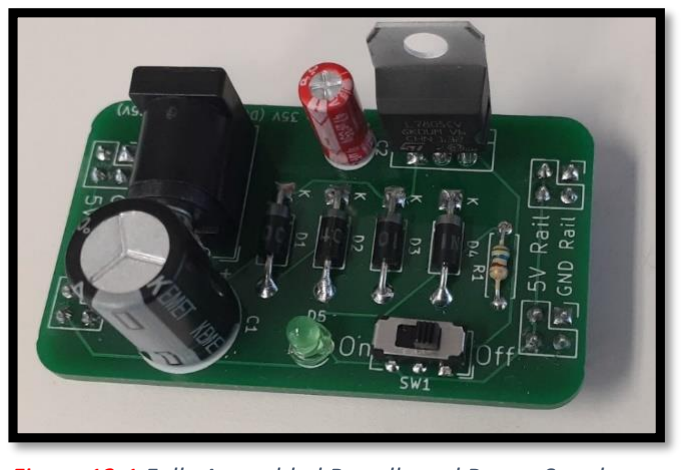
[picture p39: figure]

Figure 12-1 Fully Assembled Breadboard Power Supply

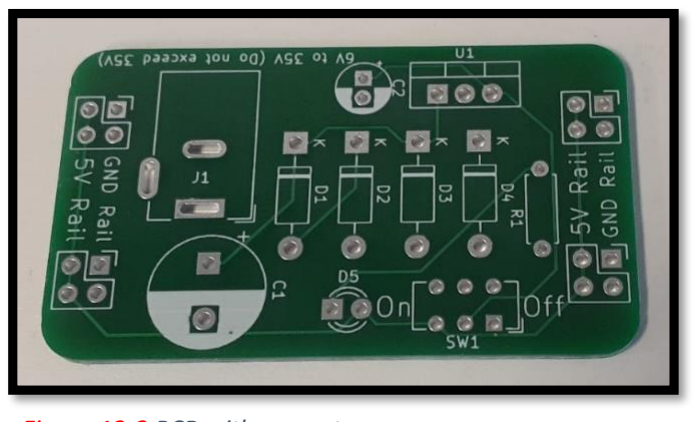
[picture p40: figure]

Figure 12-2 PCB with no parts

Start by soldering diodes D1 – D4.

Make sure the orientation is correct, the silver

band is the cathode and goes toward the K.

Solder R1; R1s orientation is not

important. D5 the LED must be soldered with

the proper orientation. There is a flat side on

the collar of the LED, this flat side should be

associated with the short lead. The short lead

and flat side collar should be soldered to the

square pad. The long lead of the LED goes to

the round pad, toward SW1.

The electrolytic capacitors are polarity

sensitive and must be installed correctly.

Solder the negative pins to the round pad with

the white and the positive pin to the square

pad.

The barrel plug input adapter has kinked

pins. At first this part can be a little difficult to

get into position. Make sure to align the pins

and then press hard and it should snap into

place. Orient the L7805 as seen in the picture,

front to the circuit and back to open space.

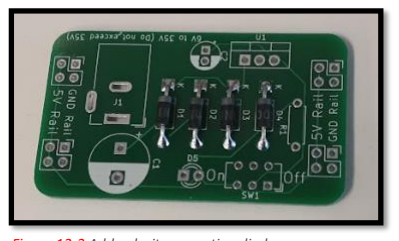
[picture p41: figure]

Figure 12-3 Add polarity correction diodes

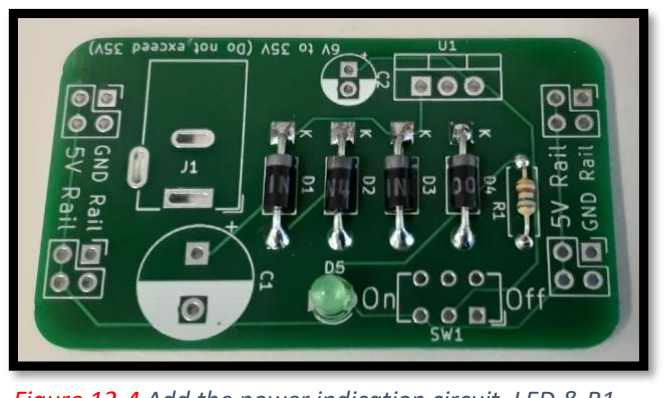
[picture p42: figure]

Figure 12-4 Add the power indication circuit, LED & R1

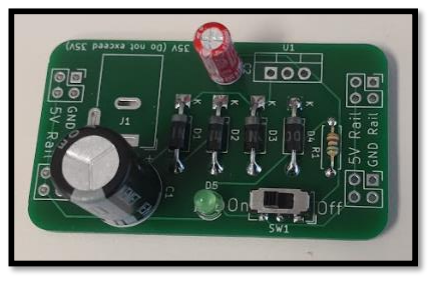
[picture p43: figure]

Figure 12-5 Add Filter Capacitors

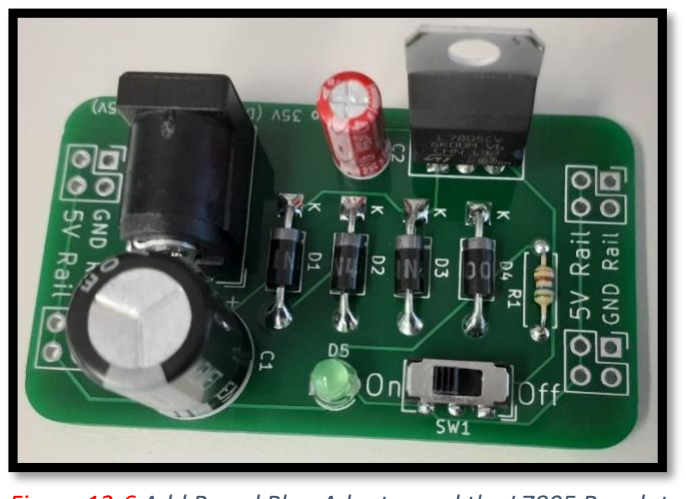
[picture p44: figure]

Figure 12-6 Add Barrel Plug Adapter and the L7805 Regulator

Snap off the header pins in 2x2 groups. The easiest way to do this is to use two needle

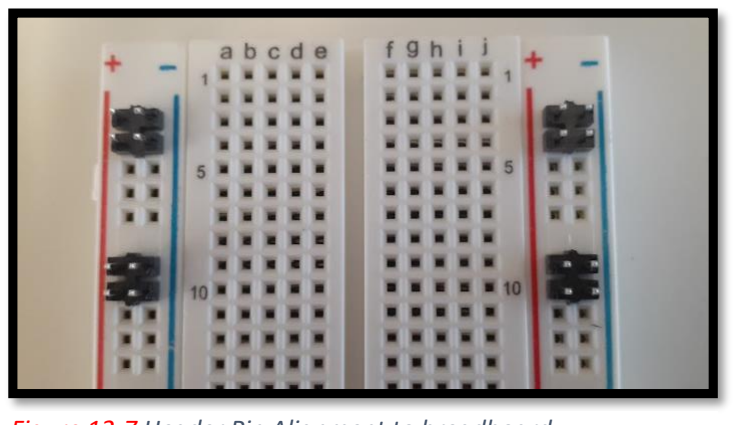
[picture p45: figure]

nose plyers. On the breadboard there are five

pin groups going down the power rails.

Orientate the header pins as seen in the

picture in the first slots of two adjoining five

pin groups. Notice the snap off tabs are all

oriented in the same direction.

Place the PCB on the header pins and press

firmly to make sure all the header pins are square and

flush to the breadboard. Solder the header pins in

place, from

the top of

the PCB.

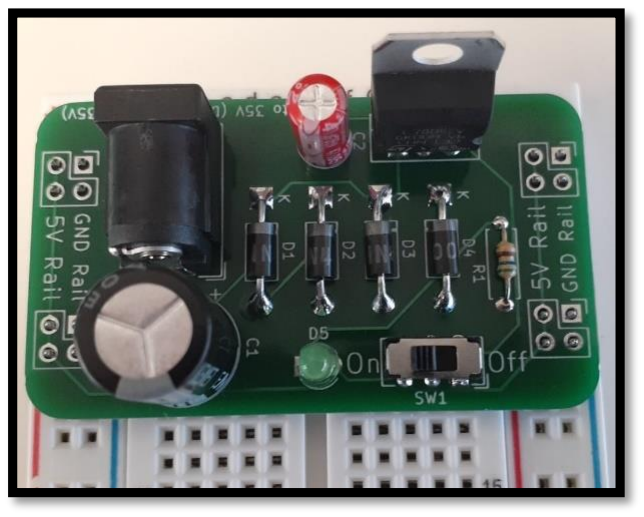
[picture p46: figure]

After soldering the header pins, the Breadboard

Power Supply is complete. Plug in your ACDC wall

adapter. Test that the green led turns on and off with

SW1 and verify that both power rails have 5VDC.

Figure 12-7 Header Pin Alignment to breadboard

Figure 12-8 Place PCB on header pins.

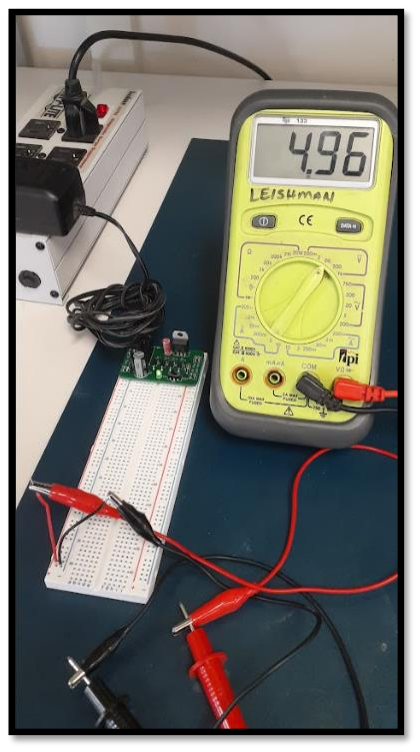
[picture p47: figure]
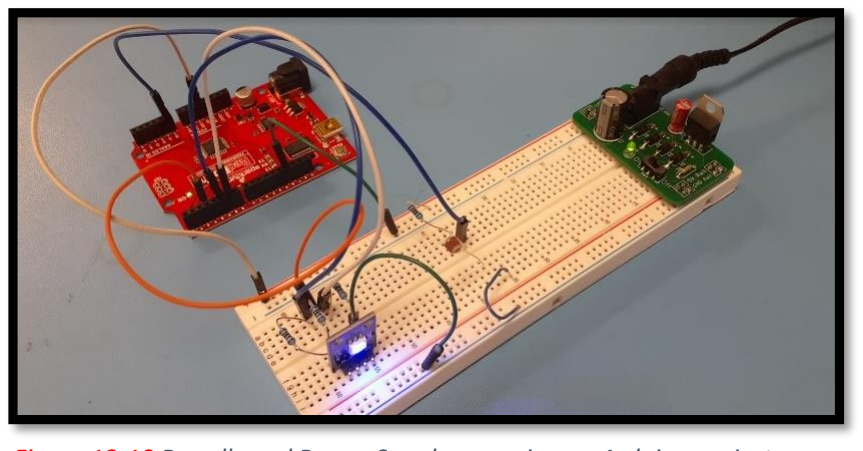
[picture p48: figure]

Figure 12-10 Breadboard Power Supply powering an Arduino project. Figure 12-9 Final Test

Conclusion

I hope you enjoyed this lesson on linear regulated power supplies. Now put your new

breadboard power supply to work and develop lots of cool electronic projects. If you are

interested in a career in electronics, consider taking your skills to the next level by studying with

me at Idaho State University’s Robotics and Communications Systems Engineering Technology

program. We are happy to give program tours! So, come check us out. Please contact me at

leistimo@isu.edu .

If you are a Middle School or High School STEM teacher please connect with me and

consider purchasing the Breadboard Power Supply kits from the Idaho State University

Electronics Club. The proceeds earned from the Breadboard Power Supply kits will help support

students at the Skills USA competition and other club events. Please contact me at

leistimo@isu.edu .

References

OSHA. (n.d.). Basic Electricity Safety - Occupational Safety and Health Administration. Train-the-Trainer: Basic Electrical Safety. Retrieved May 18, 2022, from https://www.osha.gov/sites/default/files/2019-04/Basic_Electricity_Materials.pdf

ONSEMI. (n.d.). 1N4001 Datasheet. Digi-Key. Retrieved May 18, 2022, from https://www.onsemi.com/pdf/datasheet/1n4001-d.pdf

STMicroelectronics. (n.d.). 2N3904 Datasheet. Digi-Key. Retrieved May 18, 2022, from https://media.digikey.com/pdf/Data%20Sheets/ST%20Microelectronics%20PDFS/2N3904 .pdf (https://media.digikey.com/pdf/Data%20Sheets/ST%20Microelectronics%20PDFS/2N3904.pdf)

Portable Powerguides.com. (n.d.). How Many Amps Is A 9 Volt Battery? (With its Watt & Usage). Retrieved May 18, 2022, from https://portablepowerguides.com/how-many-amps-is-a-9-volt-battery/ (https://portablepowerguides.com/how-many-amps-is-a-9-volt-battery/)

ON Semiconductor. (n.d.). Zener Diodes Datasheet. Digi-Key. Retrieved May 18, 2022, from https://www.onsemi.com/pdf/datasheet/1n5221b-d.pdf

Positive Polarity Negative Polarity Image. (n.d.). Retrieved May 18, 2022, from https://i.stack.imgur.com/zsp7C.png.

ON Semiconductor. (n.d.). TIP41 Datasheet. Digi-Key. Retrieved May 18, 2022, from https://media.digikey.com/pdf/Data%20Sheets/ON%20Semiconductor%20PDFs/TIP41A-D.pdf (https://media.digikey.com/pdf/Data%20Sheets/ON%20Semiconductor%20PDFs/TIP41A-D.pdf)

STMicroelectronics. (n.d.). L7805 Datasheet. Digi-Key. Retrieved May 18, 2022, from https://www.st.com/content/ccc/resource/technical/document/datasheet/41/4f/b3/b0/12/d4/47/88/CD00000444.pdf/files/CD00000444.pdf/jcr:content/translations/en.CD000004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 f (https://www.st.com/content/ccc/resource/technical/document/datasheet/41/4f/b3/b0/12/d4/47/88/CD00000444.pdf/files/CD00000444.pdf/jcr:content/translations/en.C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)

DIODES INC. (n.d.). 7805 Datasheet. Digi-Key. Retrieved May 18, 2022, from https://www.diodes.com/assets/Datasheets/AS78XXA.pdf

WURTH ELEKTRONIK. (n.d.). LED Datasheet. Digi-Key. Retrieved May 18, 2022, from https://www.we-online.com/katalog/datasheet/151031VS06000.pdf
