leistimo/BreadboardPowerSupplyBook/(commit log)

2022-04-01 adding kicad images and second paragraph
    [Book Images.kicad_pcb, Book Images.sch]
2022-05-11 updated formating and added unregulated section
    [Book Images.sch]
2022-05-12 finished BJT regulators starting 7805
    [Book Images.sch]
2022-05-13 Current Limiting and Darlington
2022-06-21 updated corrections
    [Book Images.sch]
2022-06-21 change electronic circuit design process sentence on page 2
2023-01-09 added pictures
    [BBPS_Article_Schematics.kicad_pcb, BBPS_Article_Schematics.sch]
2023-01-10 ISTEM parts list
    [PartsList.xlsx]
2023-01-10 Flex Sensor and Stepper Motor Kit
    [PartsList.xlsx]
2023-03-08 updated Excel for ISTEM
    [PartsList.xlsx]
2023-04-03 updated parts list
    [ParticipantsList.xlsx, PartsList.xlsx]
2023-04-06 added toolbox
    [PartsList.xlsx]
2023-04-07 corrected Walmart spelling
    [PartsList.xlsx]
